dennisjamescox/myawos/v4/media/display/ww01.gif

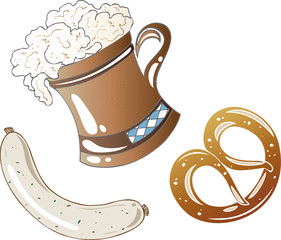
v4/media/display/ww01.gif
