dennisjamescox/myawos/v4/Docu/20230508_175125_s.jpg

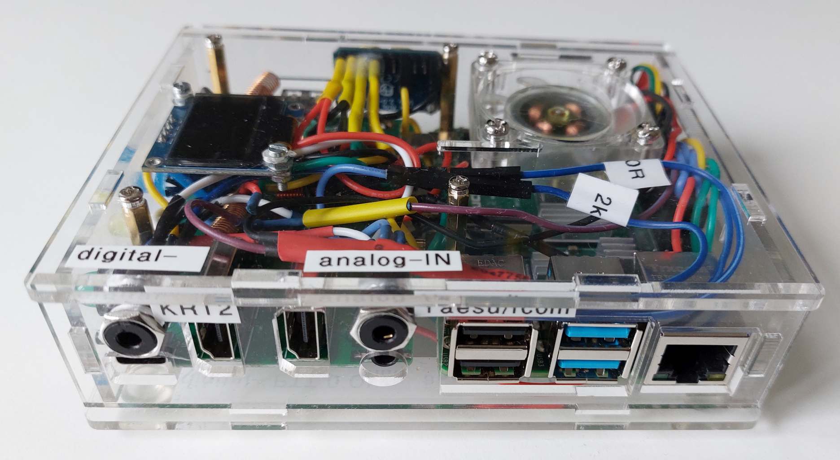
v4/Docu/20230508_175125_s.jpg
