dennisjamescox/myawos/v4/Docu/Weather_Station_rPi_ADS1115_LM393_Pinout.pdf

Weather Station Raspberry Pi / ADS1115 / LM393 Cabling | Johann Wiesheu, May 2023

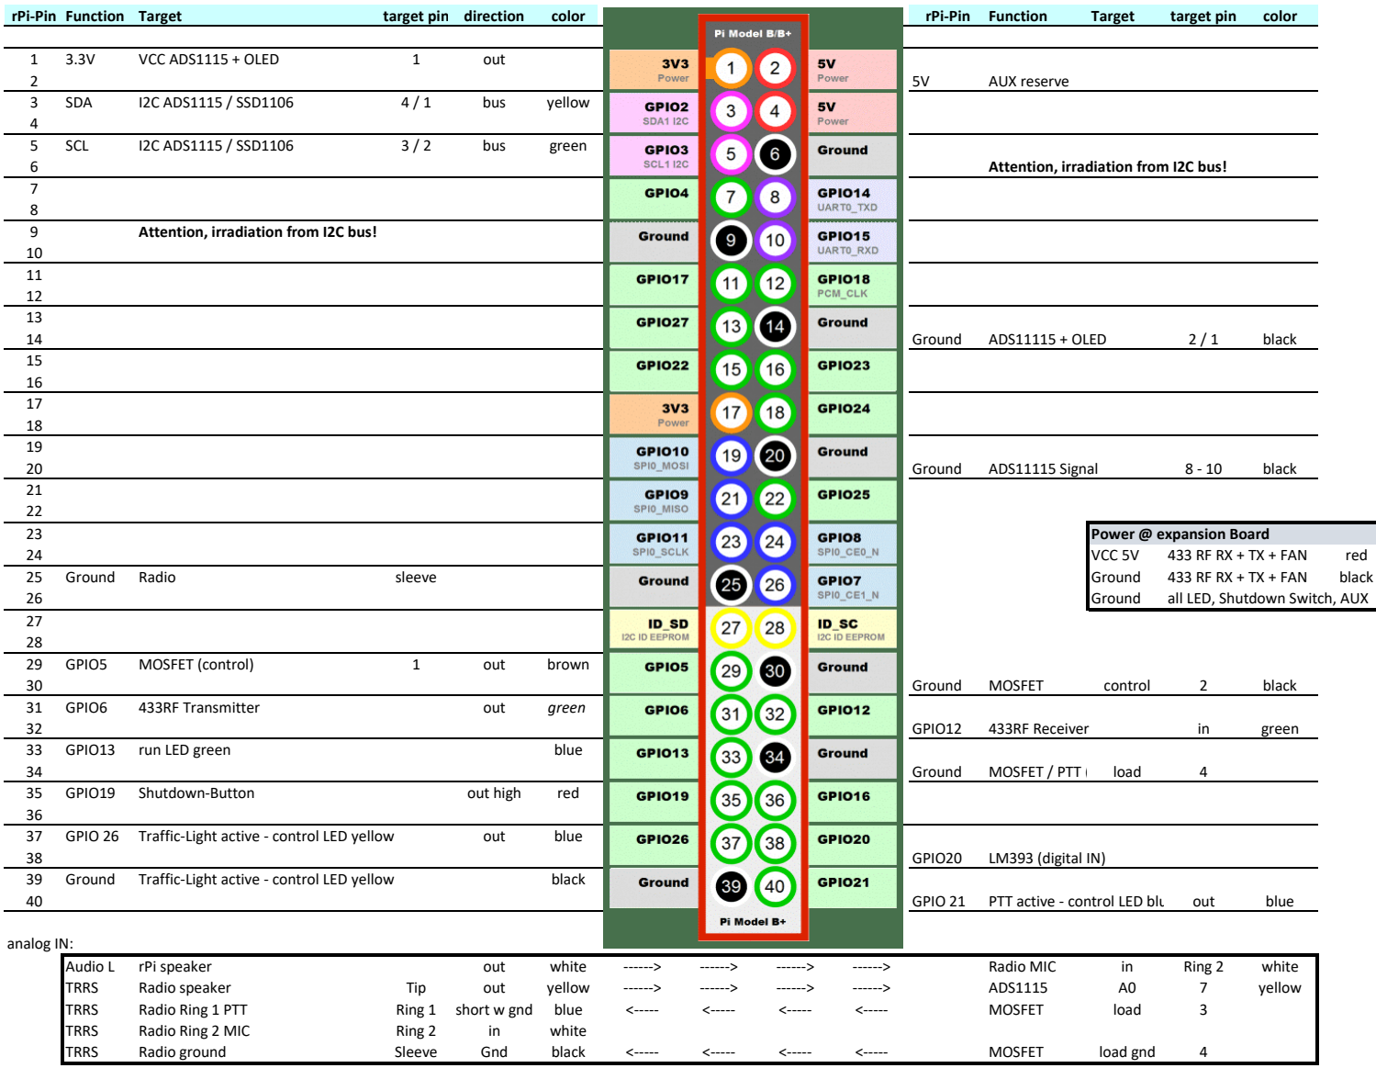
[picture p3: figure]
rPi-Pin Function Target; target pin direction; color; rPi-Pin Function; Target; target pin; VCC ADS1115 + OLED; out; AUX reserve; SDA; I2C ADS1115 / SSD1106; bus; yellow; SCL; green; Attention, irradiation from I2C bus!; Ground; ADS11115 + OLED; black; ADS11115 Signal; Power @ expansion Board; VCC 5V; 433 RF RX + TX + FAN; red; all LED, Shutdown Switch, AUX; GPIO5; MOSFET (control); brown; MOSFET; control; GPIO6; 433RF Transmitter; GPIO12; 433RF Receiver; GPIO13; run LED green; blue; GPIO19; Shutdown-Button; out high; GPIO20; LM393 (digital IN); analog IN:; Audio L; rPi speaker; white; Radio MIC; Ring 2; TRRS; Radio speaker; Tip; ADS1115; Radio Ring 1 PTT; Ring 1 short w gnd; load; Radio Ring 2 MIC; Radio ground; Sleeve; Gnd; load gnd

25 | Ground | Radio | sleeve | Ground | 433 RF RX + TX + FAN | black
34 | Ground | MOSFET / PTT (radio ground) load | 4
37 | GPIO 26 | Traffic-Light active - control LED yellow | out | blue
39 | Ground | Traffic-Light active - control LED yellow | | black
40 | GPIO 21 | PTT active - control LED blue out | blue

digital IN:
Audio L | rPi speaker | | out | white | ------> | ------> | ------> | ------> | Radio MIC | in | Ring 2 | white
TRRS | LM393 d-out | Tip | out | yellow | ------> | ------> | ------> | ------> | digital IN | GPIO20 | 38 | yellow
TRRS | Radio Ring 1 PTT | Ring 1 short w gnd | blue | <----- | <----- | <----- | <----- | MOSFET | load | 3
TRRS | Radio Ring 2 MIC | Ring 2 | in | white
TRRS | Radio ground | Sleeve | Gnd | black | <----- | <----- | <----- | <----- | MOSFET | load gnd | 4
