dennisjamescox/myawos/v2/Docu/cabling/Arduino_rPi/Weather_Station_rPi_Arduino_Pinout.xlsx

rPi-Pin | Function | Target
2 | VCC 5V | Relais |  | red
4 | VCC 5V | 433RF Transmiter |  | red
4 | VCC 5V | 433RF Receiver |  | red
5 | GPIO 13 | Shutdown-Button | out high | yellow, thin
6 | Ground | 433 RF Transmiter |  | brown
7 | GPIO 4 | 433RF Receiver | in / rx | orange
8 | GPIO 14 | Relais Handheld Radio | out/on/off | orange
9 | Ground | 433RF Receiver |  | black
11 | GPIO 17 | 433RF Transmiter | out / tx | orange
14 | Ground | Relais |  | black
17 | 3,3V | Fan |  | red
20 | Ground | Fan |  | black
22 | GPIO25 | GO for read handheld signal / RTS | out | brown
34 | Ground | Shutdown-Button + red Run LED |  | yellow, thin
36 | GPIO16 | run LED | out hight | yellow, thin
39 | Ground | Traffic-Light active control LED |  | brown
40 | GPIO 21 | Traffic-Light active control LED |  | brown
29 | GPIO5 | MOSFET
30 | Ground | MOSFET
