dennisjamescox/myawos/v2/Docu/cabling/rPi_ADS1115/Weather_Station_rPi_ADS1115_Pinout.xlsx

 |  | Weather Station Raspberry Pi / ADS1115 Cabling |  |  |  |  |  |  |  |  |  | Johann Wiesheu, Mar 2023
rPi-Pin | Function | Target | target pin | direction | color |  |  |  |  | rPi-Pin | Function | Target | target pin | color
1 | 3.3V | VCC ADS1115 + OLED | 1 | out
2 |  |  |  |  |  |  |  |  |  | 5V | AUX reserve
3 | SDA | I2C ADS1115 / SSD1106 | 4 / 1 | bus | yellow
4
5 | SCL | I2C ADS1115 / SSD1106 | 3 / 2 | bus | green
6 |  |  |  |  |  |  |  |  |  |  | Attention, irradiation from I2C bus!
7
8
9 |  | Attention, irradiation from I2C bus!
10
11
12
13
14 |  |  |  |  |  |  |  |  |  | Ground | ADS11115 + OLED |  | 2 / 1 | black
15
16
17
18
19
20 |  |  |  |  |  |  |  |  |  | Ground | ADS11115 Signal |  | 8 - 10 | black
21
22
23 |  |  |  |  |  |  |  |  |  |  |  | Power @ expansion Board
24 |  |  |  |  |  |  |  |  |  |  |  | VCC 5V | 433 RF RX + TX + FAN |  | red
25 | Ground | Radio | sleeve |  |  |  |  |  |  |  |  | Ground | 433 RF RX + TX + FAN |  | black
26 |  |  |  |  |  |  |  |  |  |  |  | Ground | all LED, Shutdown Switch, AUX
27
28
29 | GPIO5 | MOSFET (control) | 1 | out | brown
30 |  |  |  |  |  |  |  |  |  | Ground | MOSFET | control | 2 | black
31 | GPIO6 | 433RF Transmitter |  | out | green
32 |  |  |  |  |  |  |  |  |  | GPIO12 | 433RF Receiver |  | in | green
33 | GPIO13 | run LED green |  |  | blue
34 |  |  |  |  |  |  |  |  |  | Ground | MOSFET / PTT (radio ground) | load | 4
35 | GPIO19 | Shutdown-Button |  | out high | red
36
37 | GPIO 26 | Traffic-Light active - control LED yellow |  | out | blue
38 |  |  |  |  |  |  |  |  |  | GPIO20 | AUX reserve
39 | Ground | Traffic-Light active - control LED yellow |  |  | black
40 |  |  |  |  |  |  |  |  |  | GPIO 21 | PTT active - control LED blue |  | out | blue
 | Audio L | rPi speaker |  | out | white | ------> | ------> | ------> | ------> |  | Radio MIC | in | Ring 2 | white
 | TRRS | Radio speaker | Tip | out | orange | ------> | ------> | ------> | ------> |  | ADS1115 | A0 | 7 | orange
 | TRRS | Radio Ring 1 PTT | Ring 1 | short w gnd | blue | <----- | <----- | <----- | <----- |  | MOSFET | load | 3
 | TRRS | Radio Ring 2 MIC | Ring 2 | in | white
 | TRRS | Radio ground | Sleeve | Gnd | black | <----- | <----- | <----- | <----- |  | MOSFET | load gnd | 4
