dennisjamescox/myawos/v4/Docu/20230508_174907_s.jpg

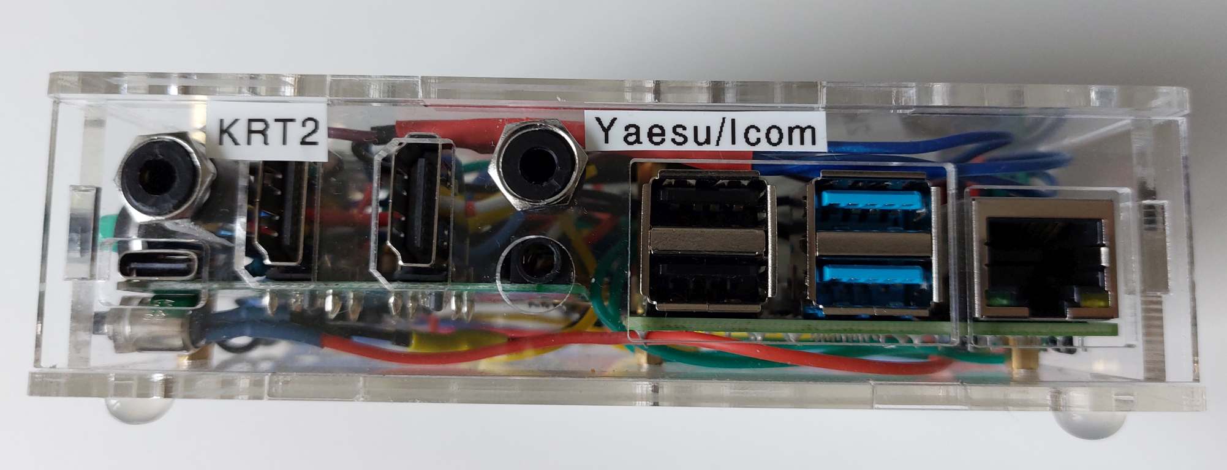
v4/Docu/20230508_174907_s.jpg
