dennisjamescox/myawos/v4/Docu/cabling/Radios/FT-250R_FT270R pinouts + 4 pin plug.jpg

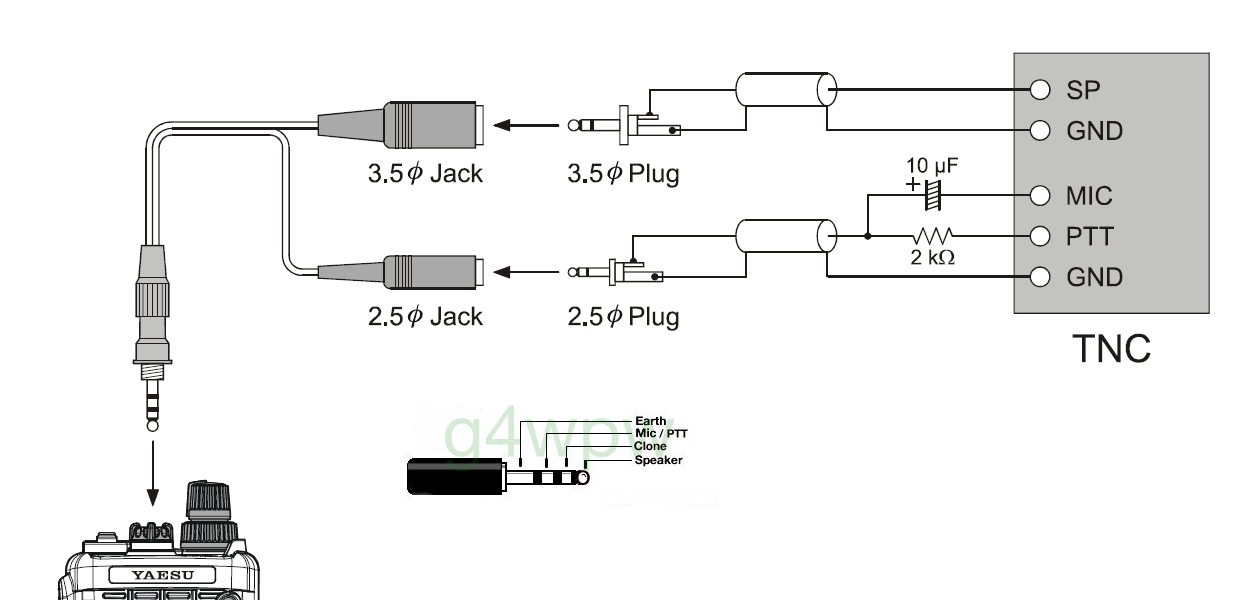
v4/Docu/cabling/Radios/FT-250R_FT270R pinouts + 4 pin plug.jpg
