dennisjamescox/myawos/v4/Docu/cabling/Radios/KRT2-xs.jpg

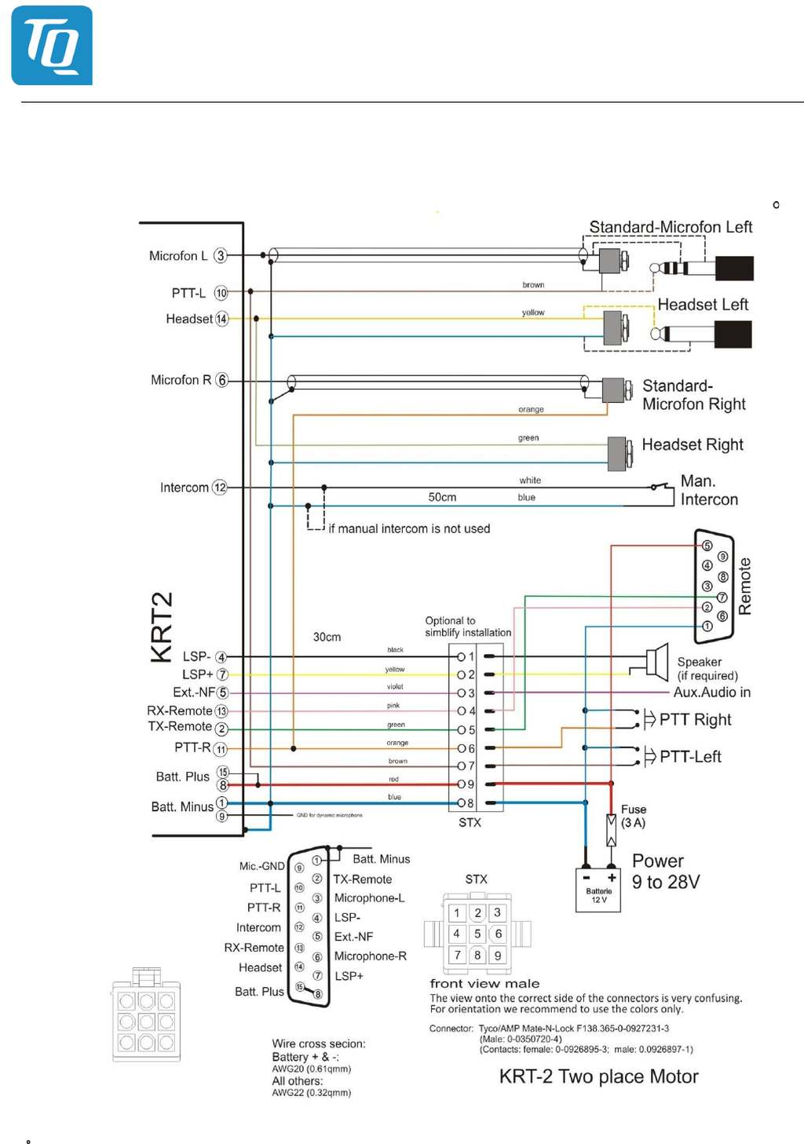
v4/Docu/cabling/Radios/KRT2-xs.jpg
