dennisjamescox/myawos/v4/Docu/cabling/rPi_LM393/rPi_LM393mod_KRT2.jpg

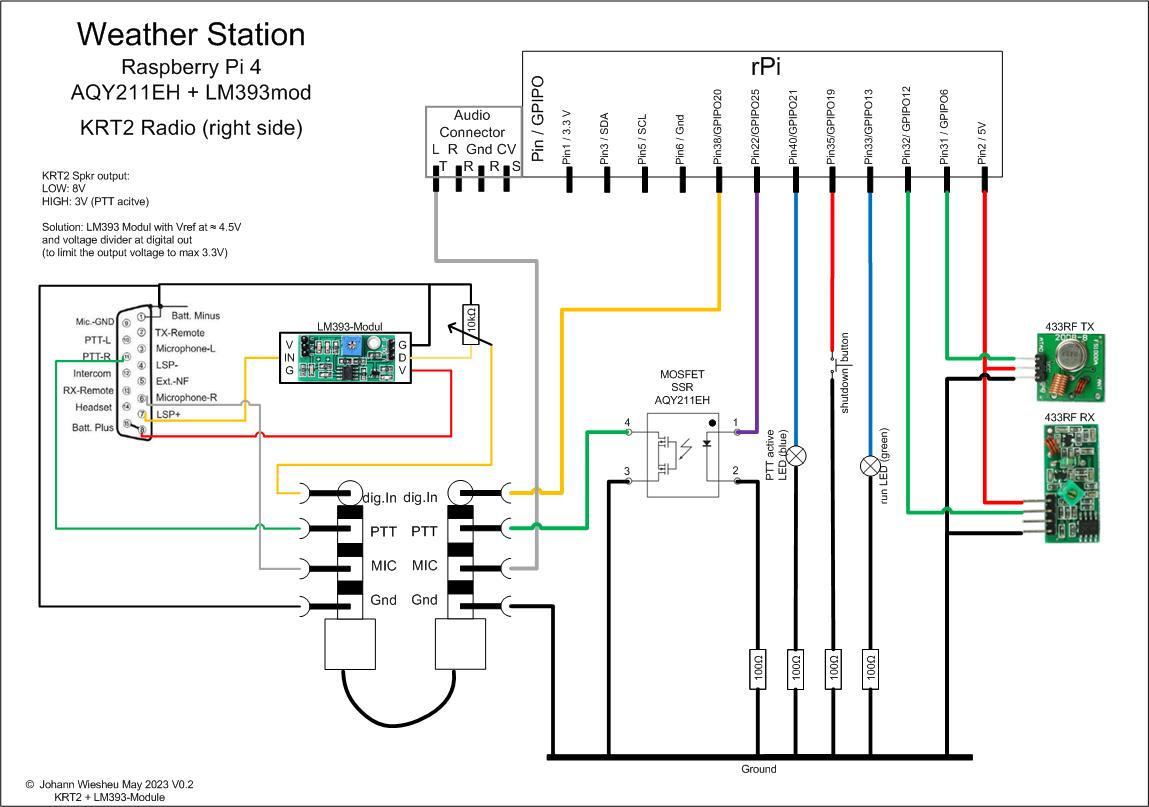
v4/Docu/cabling/rPi_LM393/rPi_LM393mod_KRT2.jpg
