dennisjamescox/myawos/v4/Docu/LM393_modul_pin.jpg

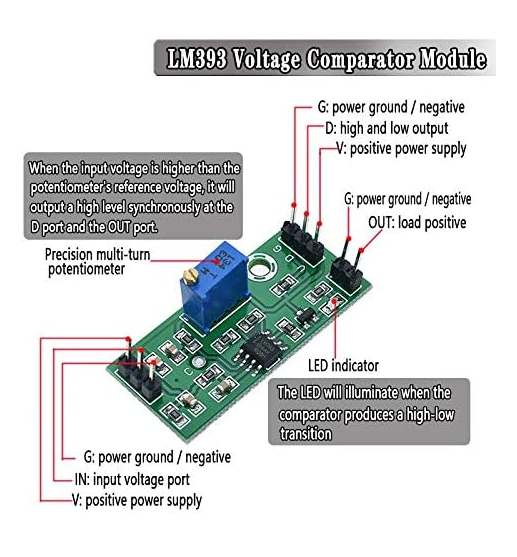
v4/Docu/LM393_modul_pin.jpg
