dennisjamescox/myawos/v4/Docu/LM393_modul_size.jpg

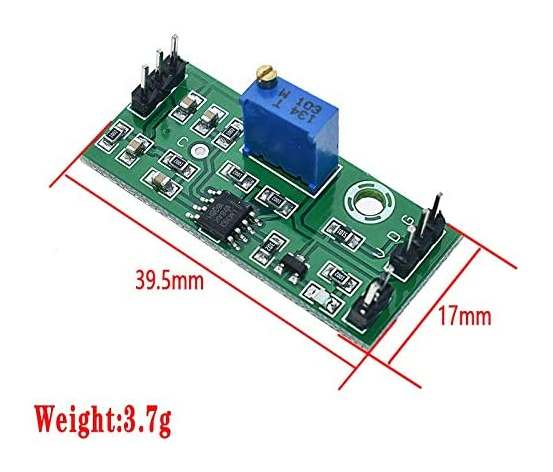
v4/Docu/LM393_modul_size.jpg
