dennisjamescox/myawos/v4/Docu/rPi-LM393_v2.jpg

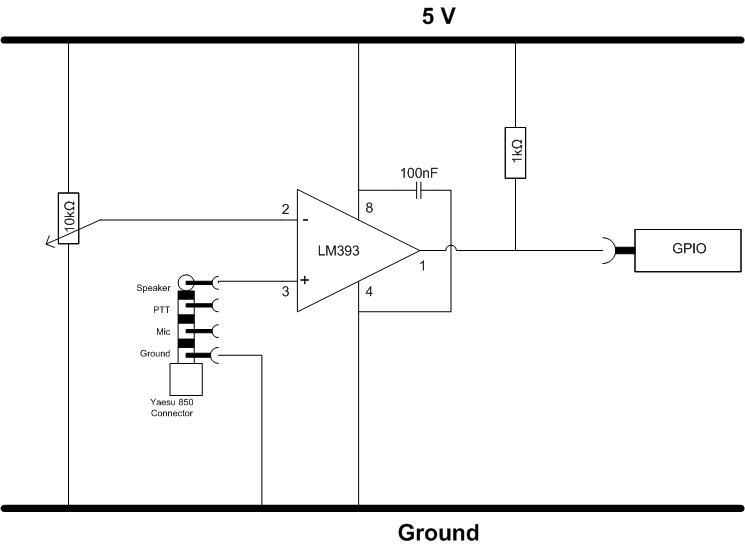
v4/Docu/rPi-LM393_v2.jpg
