dennisjamescox/myawos/v4/media/display/snoopy-28.gif

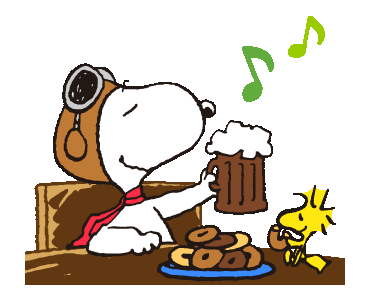
v4/media/display/snoopy-28.gif
