dennisjamescox/myawos/v4/media/display/snoopy-30.gif

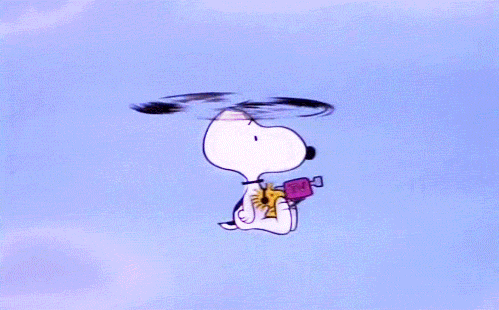
v4/media/display/snoopy-30.gif
