dennisjamescox/myawos/v4/media/display/snoopy-35.gif

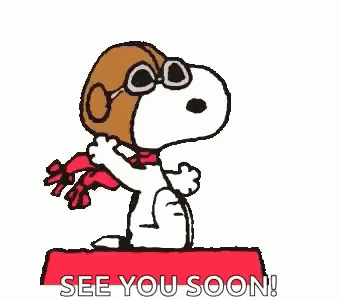
v4/media/display/snoopy-35.gif
