dennisjamescox/myawos/v4/media/display/warteaufclick.gif

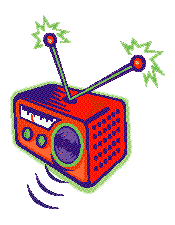
v4/media/display/warteaufclick.gif
