dennisjamescox/myawos/v4/Docu/cabling/Radios/Icom_Airband_2_Pin_Wiring.jpg

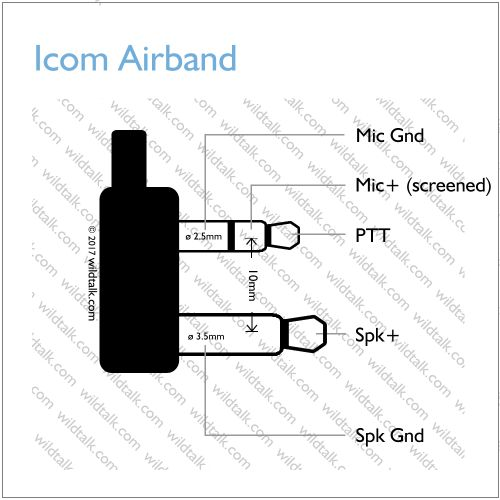
v4/Docu/cabling/Radios/Icom_Airband_2_Pin_Wiring.jpg
