dennisjamescox/myawos/v4/Docu/cabling/Radios/SCU-15_pinout_manual_Y550.png

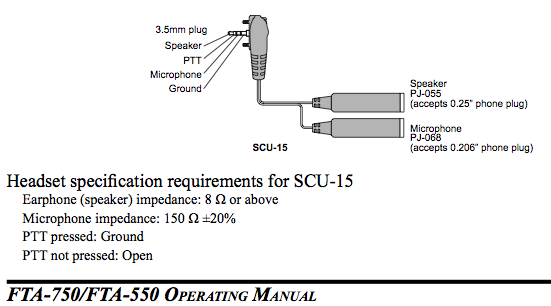
v4/Docu/cabling/Radios/SCU-15_pinout_manual_Y550.png
