dennisjamescox/myawos/i2c_ads1015.c

/*
 * December 21 2022
 * dennisjcox@gmail.com
 */


#include <stdio.h>
#include <stdint.h>
#include <unistd.h>
#include <stdlib.h>
#include <wiringPiI2C.h>

#include "i2c_ads1015.h"


int main(int argc, char *argv[])
{

  
  return 0;
}
