dennisjamescox/myawos/(commit log)

2022-11-17 Fixed a number of issues. Made convert perl script simplier. Added all the rounding to weather.py so the output into weather.txt would be clean
    [weather.py]
2022-12-21 Fix some playback issues and added some debugging information
    [click_listen.py]
2022-12-23 Support for the sample file
2023-04-11 Johann Requested
    [Weather_Station_rPi_ADS1115_Pinout.xlsx, Weather_Station_rPi_Arduino_Pinout.xlsx]
2023-04-13 cleanup v2 by Johann
    [Weather_Station_rPi_Arduino_Pinout.xlsx]
2023-04-21 Update click_listen357.py
    changed Johann's email address to info@myawos.de
2023-05-31 V4 errorhandling
    V4 - add errorhandling for ecowitt timeout
    [ecowitt_getweather.py, weather_to_speech.py]
